matthewpanizza/DecentralizedLV-ULPDRV/(commit log)

2025-02-02 Initial Commit without Boards
2025-02-02 Re-Add Boards API
